d-e-c-d/eolia/docs/charte/modeles/eolia_modele_presentation.pptx

## [Titre de la présentation]

[Sous-titre : ce que la présentation démontre, en une phrase]

[Prénom Nom], [Prénom Nom], [Prénom Nom]
Smart Realization X5, UCAC-ICAM, [8 novembre 2026]

Notes: Diapositive de titre. Remplacer les textes entre crochets.

## Utiliser ce modèle

- Nouvelle diapositive : onglet Accueil, Nouvelle diapositive, puis choisir une mise en page EOLIA_.
- Une idée par diapositive, un titre qui l'énonce sans point final.
- Une seule touche d'ambre par diapositive : le chiffre ou la valeur à retenir.
- Nombres à la française dans le texte : 12,6 V, 3,2 W, 45 °C.
- Installer Lexend et IBM Plex Sans (Google Fonts) sur le poste qui présente.

Notes: Supprimer cette diapositive dans la présentation finale.

## Le système

01

## Quatre agents négocient par un bus de messages

Production

Mesure le générateur, publie la puissance, détecte la surtension

Batterie

Estime l'état de charge, accorde ou refuse la décharge

Charge

Porte l'exigence de confort et négocie l'allumage

Superviseur

Mode autonome ou manuel, alarmes, écran, relais

Bus de messages (bus.h)

Les agents ne s'appellent jamais directement : chaque décision passe par un message.

## Deux modes de pilotage

Mode autonome
- Les agents appliquent eux-mêmes leurs décisions.
- La lampe s'allume si la batterie est au-dessus de la réserve.
- Commande série : MODE AUTO

Mode manuel
- Les agents proposent, l'utilisateur accepte ou refuse.
- Surchauffe et batterie basse restent prioritaires.
- Commande série : MODE MANU

## Résultats

02

## Capacité de stockage de la batterie

84 Wh

Batterie plomb 12 V, 7 Ah (CAPACITE_BAT_WH dans config.h). Remplacer par le résultat à retenir.

## [La puissance croît avec la vitesse de rotation]

Données d'exemple
Clic droit sur la courbe, Modifier les données, puis coller les mesures exportées par outils/courbes.py.
Toujours donner l'unité entre parenthèses sur chaque axe.

## Seuils de sécurité du firmware

Constante | Rôle | Valeur
V_GEN_MAX | Surtension du générateur | 25,0 V
V_BAT_MAX | Surcharge de la batterie | 14,6 V
V_BAT_COUPURE | Coupure de la lampe | 11,8 V
V_BAT_REARME | Réarmement après coupure | 12,2 V
T_BAT_MAX | Surchauffe de la batterie | 45,0 °C

Source : firmware/eolia/config.h

## Merci

Questions ?
[Prénom Nom], [adresse électronique]
Dépôt du projet : [lien]
