d-e-c-d/eolia/docs/charte/modeles/eolia_modele_rapport.docx

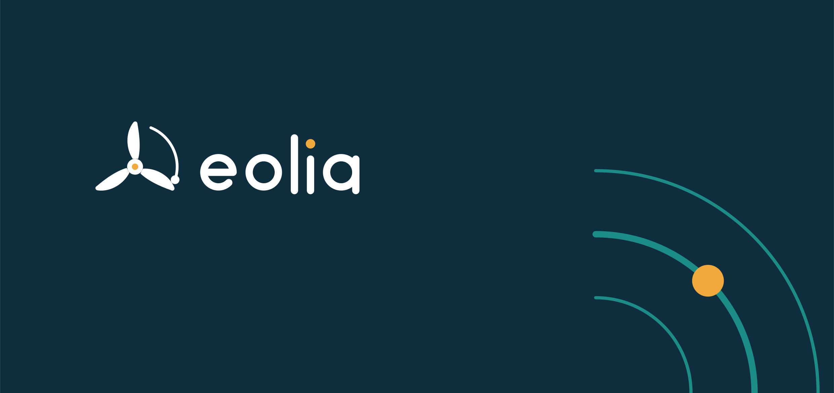
[picture p1: figure]
Bandeau bleu nuit avec le logo Eolia

RAPPORT TECHNIQUE

# [Titre du document]

[Sous-titre : ce que le document établit, en une phrase]

Équipe

[Prénom Nom], [Prénom Nom], [Prénom Nom], [Prénom Nom]

Encadrant

[Prénom Nom]

Sommaire

# 1 Utiliser ce modèle

Ce modèle applique la charte graphique Eolia. Remplacer les textes entre crochets, puis supprimer les exemples des pages suivantes. Pour que la mise en forme reste cohérente, n'appliquer que les styles du modèle (onglet Accueil, galerie des styles) plutôt qu'une mise en forme manuelle.

## 1.1 Styles disponibles

- Titre 1, Titre 2, Titre 3 : parties, sous-parties et intertitres. Ils alimentent le sommaire.
- Normal : texte courant en IBM Plex Sans 10,5 pt, interligne 1,5.
- Légende : sous les figures et au-dessus des tableaux.
- Encadré : remarque ou point de sécurité, sur fond brume.
- Trame : extraits de code, de trame série ou de commande, en IBM Plex Mono.

## 1.2 Mettre à jour le sommaire et les numéros de page

Le sommaire se met à jour par un clic droit sur le sommaire, puis Mettre à jour les champs. Le nombre total de pages du pied de page se met à jour de la même manière, ou à l'impression.

### Règles d'écriture

Nombres à la française dans le texte : virgule décimale et espace avant l'unité (12,6 V ; 3,2 W ; 45 °C). Dans le code et les trames série, le point décimal reste. Pas de tiret long : utiliser la virgule, les deux-points ou les parenthèses.

# 2 Exemples de mise en forme

Les éléments ci-dessous montrent l'aspect attendu des tableaux, encadrés, trames et figures. Les valeurs du tableau 1 sont celles de config.h au 8 novembre 2026.

Tableau 1 : seuils de sécurité du firmware (config.h)

Constante | Rôle | Valeur | Unité
V_GEN_MAX | Surtension générateur (limite de l'INA219 : 26 V) | 25,0 | V
V_BAT_MAX | Surcharge de la batterie plomb | 14,6 | V
V_BAT_COUPURE | Coupure de la lampe (décharge profonde) | 11,8 | V
V_BAT_REARME | Réarmement après coupure (hystérésis) | 12,2 | V
T_BAT_MAX | Surchauffe de la batterie | 45,0 | °C

Remarque

Les coefficients de calibration des INA219 et de la NTC sont mesurés au multimètre ; la procédure est décrite dans docs/calibration.md.

Sécurité

En mode manuel, les sécurités surchauffe et batterie basse restent prioritaires : la commande FORCER 1 n'allume pas la lampe si l'une d'elles est active.

Exemple de trame série (commande puis réponse) :

> MODE MANU

< P,ALLUMER,0

< E,48210,RELAIS,1

[Insérer la figure : clic droit sur ce cadre, puis Insérer une image]

Figure 1 : puissance du générateur en fonction de la vitesse de rotation (source : mesures du [date], outils/courbes.py)

# 3 [Titre de partie]

[Texte de la partie.]

Smart Realization X5, UCAC-ICAM[8 novembre 2026], version [1.0]

Eolia, Smart Realization X5page /

[Titre court du document]
