d-e-c-d/eolia/docs/charte/modeles/arcs.png

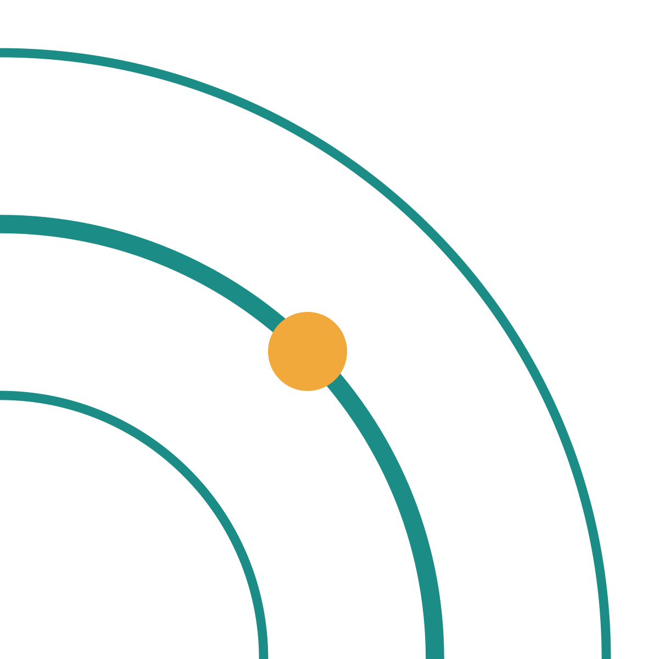
docs/charte/modeles/arcs.png
