d-e-c-d/eolia/docs/charte/modeles/eolia_symbole_blanc.png

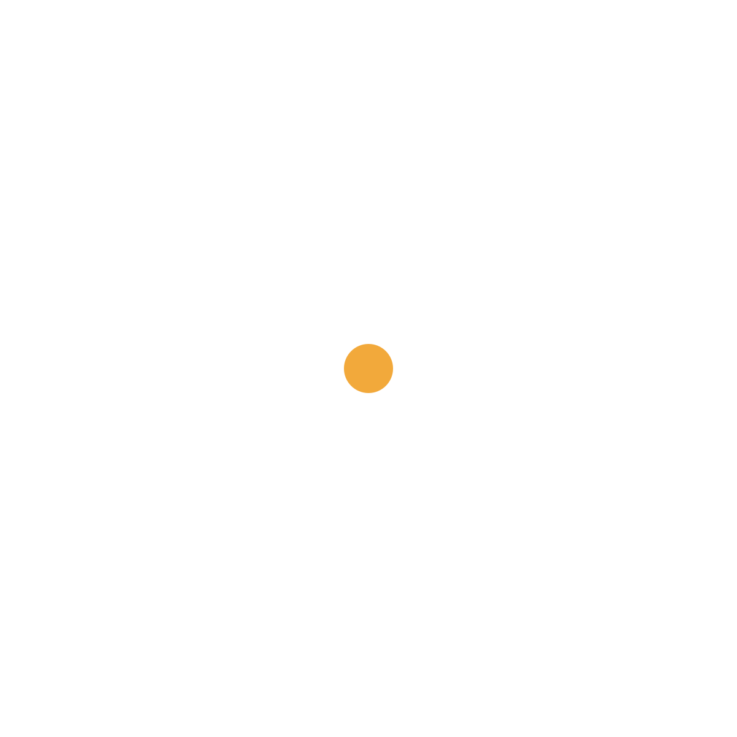
docs/charte/modeles/eolia_symbole_blanc.png
