d-e-c-d/eolia/docs/charte/modeles/eolia_symbole_couleur.png

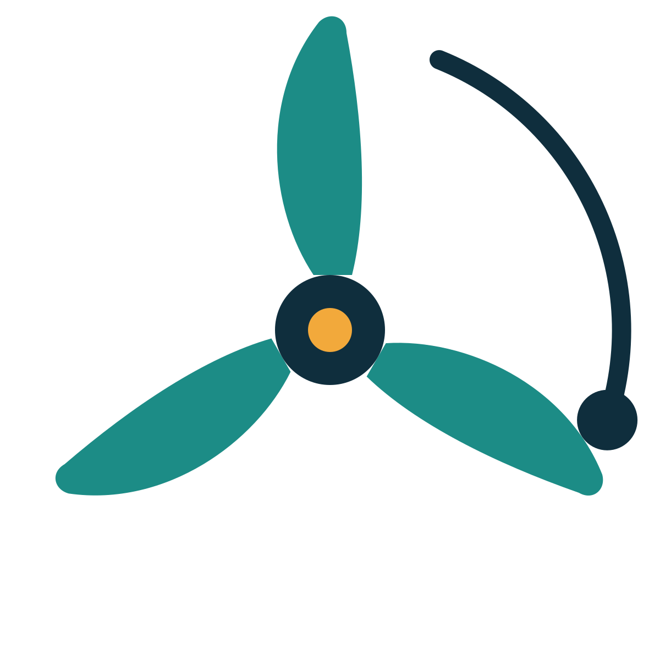
docs/charte/modeles/eolia_symbole_couleur.png
