d-e-c-d/eolia/firmware/eolia/config.h

// config.h : brochage et seuils de la mini-éolienne Eolia
// Toutes les valeurs à calibrer sont regroupées ici.
#pragma once
#include <Arduino.h>

// ---------- Brochage Arduino UNO ----------
// Conforme au schéma électrique (schema_electrique_mini_eolienne.pdf, feuille 2)
// I2C : A4 = SDA, A5 = SCL (INA219 n°1 et n°2)
const uint8_t PIN_HALL     = 2;   // A3144, sortie vers D2 (interruption INT0), pull-up 10 k + pull-up interne
const uint8_t PIN_BOUTON   = 3;   // bouton vers GND, pull-up interne
const uint8_t PIN_RELAIS   = 4;   // entrée 1A du L293D, la sortie 1Y pilote la bobine du relais K1
const uint8_t PIN_LCD_D7   = 5;   // LCD broche 14
const uint8_t PIN_LCD_D6   = 6;   // LCD broche 13
const uint8_t PIN_LED      = 7;   // LED rouge + résistance 220 ohms
const uint8_t PIN_BUZZER   = 8;   // buzzer actif
const uint8_t PIN_LCD_D5   = 9;   // LCD broche 12
const uint8_t PIN_LCD_D4   = 10;  // LCD broche 11
const uint8_t PIN_LCD_E    = 11;  // LCD broche 6
const uint8_t PIN_LCD_RS   = 12;  // LCD broche 4
const uint8_t PIN_NTC      = A0;  // 5 V -> R1 10 k -> A0 -> NTC 10 k -> GND

// ---------- Capteurs ----------
const uint8_t ADR_INA_PROD   = 0x40; // INA219 n°1 : sortie générateur
const uint8_t ADR_INA_CHARGE = 0x41; // INA219 n°2 : batterie vers lampe (pont A0 soudé)
const uint8_t AIMANTS_PAR_TOUR = 1;  // nombre d'aimants collés sur l'axe
const float   NTC_BETA  = 3950.0;
const float   NTC_R0    = 10000.0;   // 10 k à 25 °C
const float   NTC_RSERIE = 10000.0;

// ---------- Seuils de protection ----------
const float V_GEN_MAX      = 25.0;  // V : l'INA219 accepte 26 V au maximum
const float V_BAT_MAX      = 14.6;  // V : surcharge batterie plomb
const float V_BAT_COUPURE  = 11.8;  // V : coupure de la lampe (décharge profonde)
const float V_BAT_REARME   = 12.2;  // V : réarmement après coupure (hystérésis)
const float T_BAT_MAX      = 45.0;  // °C : surchauffe

// ---------- Exigences de confort par défaut (modifiables par l'utilisateur) ----------
const uint8_t RESERVE_SOC_DEFAUT = 40;  // % de charge à garder en réserve
const uint8_t HYST_RESERVE       = 10;  // points de % à regagner avant de rallumer

// ---------- Cadencement ----------
const uint16_t PERIODE_CYCLE_MS  = 200;   // un cycle de négociation des agents
const uint16_t PERIODE_TRAME_MS  = 1000;  // envoi d'une trame de mesures au PC
const uint16_t PERIODE_LCD_MS    = 500;
const uint8_t  TOURS_MAX_BUS     = 8;     // tours maximum de messages par cycle
