d-e-c-d/eolia/(commit log)

2026-11-07 Calibration des INA219 et de la NTC
    - Correction gain et décalage sur chaque voie (coefficients dans config.h)
    - Commande CAL et trame C : valeurs brutes moyennées sur 16 lectures
    - Assistant supervision.py --calib : relevé face au multimètre,
    moindres carrés, modèle bêta de la NTC, écriture dans config.h
    - Test natif de la correction et de la NTC
    - docs/calibration.md, protocole série et README mis à jour
    [config.h, eolia.ino, mesures.h, supervision.py]
2026-11-07 Etat de charge par comptage d'énergie recalé sur la tension
    - Bilan RENDEMENT_CHARGE x P_gen - P_lampe à chaque cycle, y compris pendant la charge
    - Recalage lent sur la tension hors charge (TAU_RECALAGE_S), chute due à la lampe compensée
    - Point de départ pris sur la tension à la première mesure hors charge
    - Simulation alignée sur le même modèle (CAPACITE_SIM_WH)
    - Test natif : l'estimation suit le SOC simulé dans les 4 scénarios
    - docs/etat_de_charge.md : méthode, paramètres, mesure du rendement
2026-11-07 Courbes puissance et tension selon la vitesse de rotation
    - outils/courbes.py : nuage de mesures, moyenne par tranche, ajustement P = a.N^3
    et constante du générateur, export PNG 300 dpi et SVG pour le poster
    - Capteur Hall : mesure par la période entre fronts au lieu du comptage
    sur 200 ms (qui quantifiait la vitesse par pas de 300 tr/min)
    - Test natif de la mesure de vitesse
    - README mis à jour
2026-11-08 et pieds de page, styles de titres, légende, encadré et trame - Modèle de présentation PowerPoint (.potx et .pptx) : sept mises en page et dix diapositives d'exemple - Scripts de régénération des mod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
2026-11-08 Charte graphique Eolia : logo, modèles Word et PowerPoint
    - Logo en SVG (couleur, blanc, noir), symbole seul et favicon, avec
    exports PNG et script de génération (generer_logo.py)
    - Charte dans docs/charte/README.md : couleurs, typographie (Lexend,
    IBM Plex Sans, IBM Plex Mono), règles du logo, écriture, couleurs
    des courbes, gabarits de documents
    - Modèle de rapport Word (.dotx et .docx) : page de garde, en-têtes
    et pieds de page, styles de titres, légende, encadré et trame
    - Modèle de présentation PowerPoint (.potx et .pptx) : sept mises en
    page et dix diapositives d'exemple
    - Scripts de régénération des modèles (modele_rapport.js,
    modele_di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
2026-11-11 mise a jour de 2 fichiers en vue des changements de pins
