d-e-c-d/eolia/(notices)

Notices in the files:
README.md:
License: MIT
